Twelvecat/Auto_Car_Tracking_Carry/4位595数码管相关资料/接线说明.txt

测试芯片 STC89C52 
DIO接 P1.0  RCK接P1.1  SCK接P1.2  上电 数码管会显示4 3 2 1
