Twelvecat/Auto_Car_Tracking_Carry/HC-SR04模块相关资料/222222.jpg

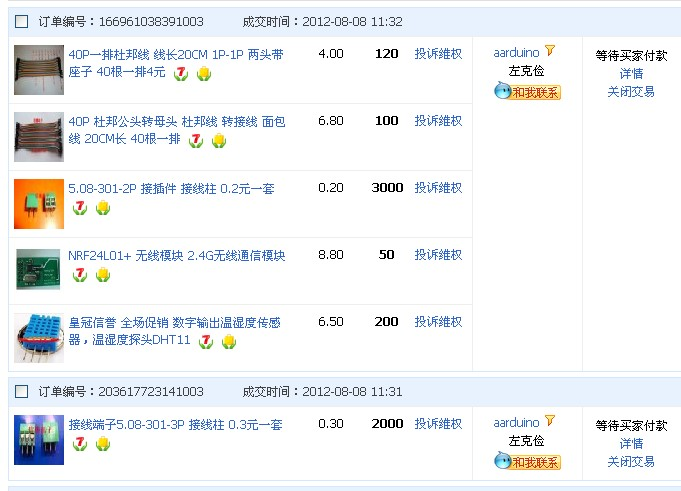
HC-SR04模块相关资料/222222.jpg
