Twelvecat/Auto_Car_Tracking_Carry/(list of files, cad)

Other CAD files:
4位595数码管相关资料/HC595驱动4位时间led的8051程序/74HC595.OBJ
HC-SR04模块相关资料/超声波测距LC1602显示/脉宽测量.OBJ
HC-SR04模块相关资料/超声波测距LCD12864显示/测距程序.OBJ
HC-SR04模块相关资料/超声波测距串口显示/测距程序.OBJ
HC-SR04模块相关资料/超声波测距数码管显示/脉宽测量.OBJ
L298N电机驱动相关资料/STARTUP.OBJ
SG90舵机相关资料/STARTUP.OBJ
4位595数码管相关资料/HC595驱动4位时间led的8051程序/STARTUP.OBJ
L298N电机驱动相关资料/电机测试.OBJ
SG90舵机相关资料/舵机测试.OBJ
