Twelvecat/Auto_Car_Tracking_Carry/4位595数码管相关资料/4位595数码管电路原理图.pdf

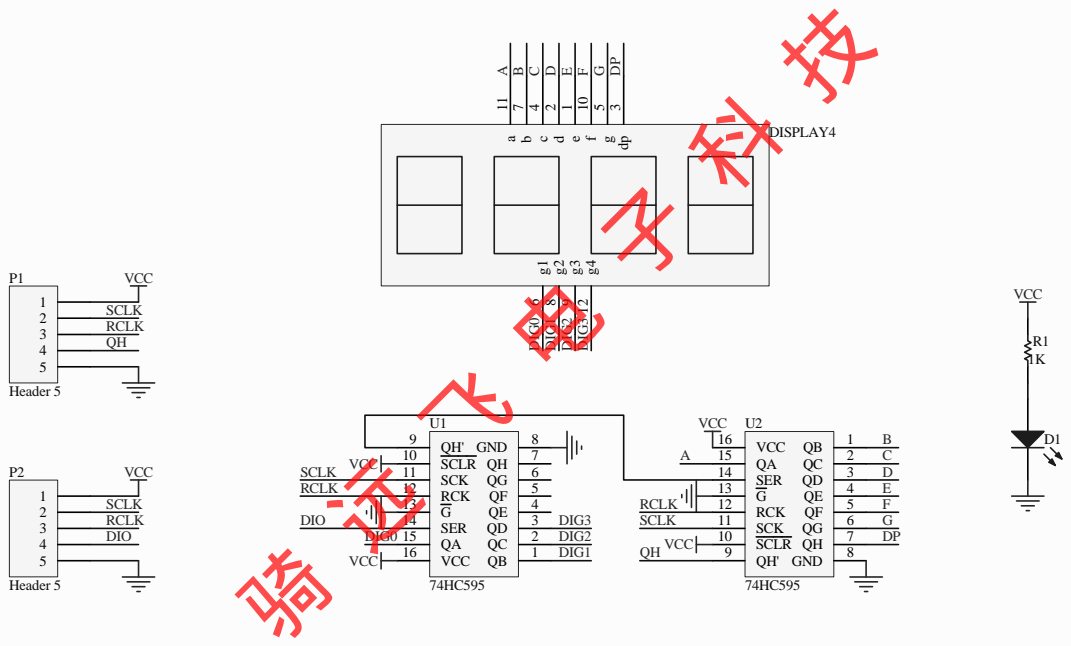
[picture p4: page 1]
Title; DISPLAY4; 7 GND; SCLR 10; SCK 11; RCK 12; SER 14; VCC 16; GND; ABCDEFG; DIG0; DIG1; DIG2; DIG3; DIO; RCLK; SCLK; VCC; VCC QH; RCLK SCLK; Header 5; SCLK RCLK QH; SCLK RCLK DIO

Size A4 | Number | Revision

Date: 2008-05-09 | Sheet of
File: E:\面置里\..\4位595数码管.SchDoc | Drawn By:
